FilippoGorini/DaisyTape/hardware/pcb/DaisyTape_BOTTOM.jpg

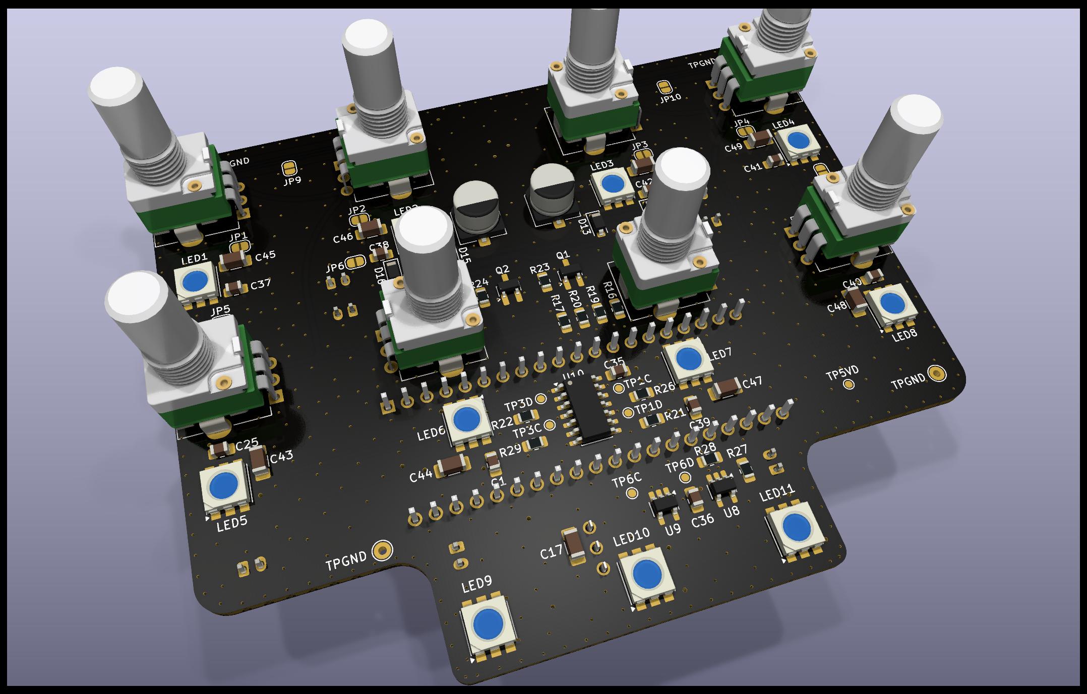
hardware/pcb/DaisyTape_BOTTOM.jpg
