FilippoGorini/DaisyTape/hardware/pcb/DaisyTape_TOP.png

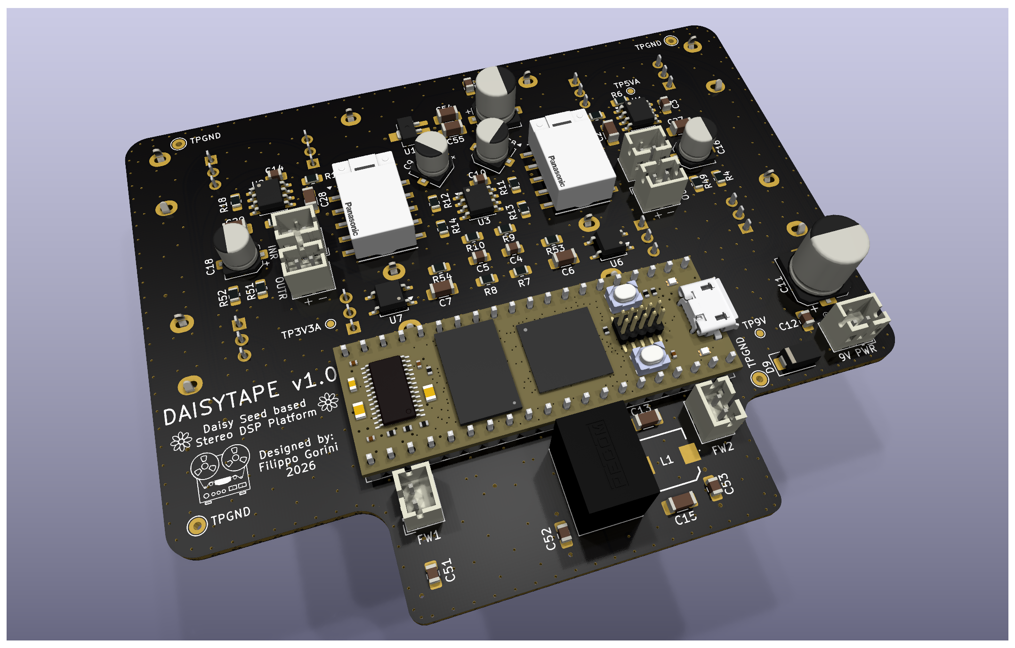
hardware/pcb/DaisyTape_TOP.png
