FilippoGorini/DaisyTape/README.md

# DaisyTape

## Author

<!-- Insert Your Name Here -->

## Description

<!-- Describe your example here -->
