FilippoGorini/DaisyTape/hardware/pcb/DaisyTape_BOTTOM.png

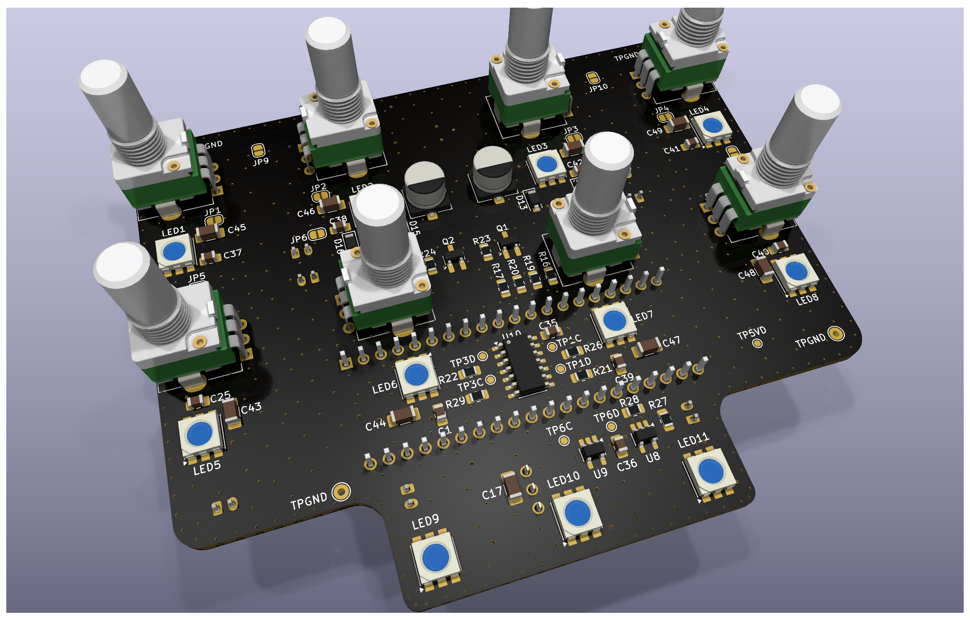
hardware/pcb/DaisyTape_BOTTOM.png
