FilippoGorini/DaisyTape/hardware/pcb/DaisyTape_TOP.jpg

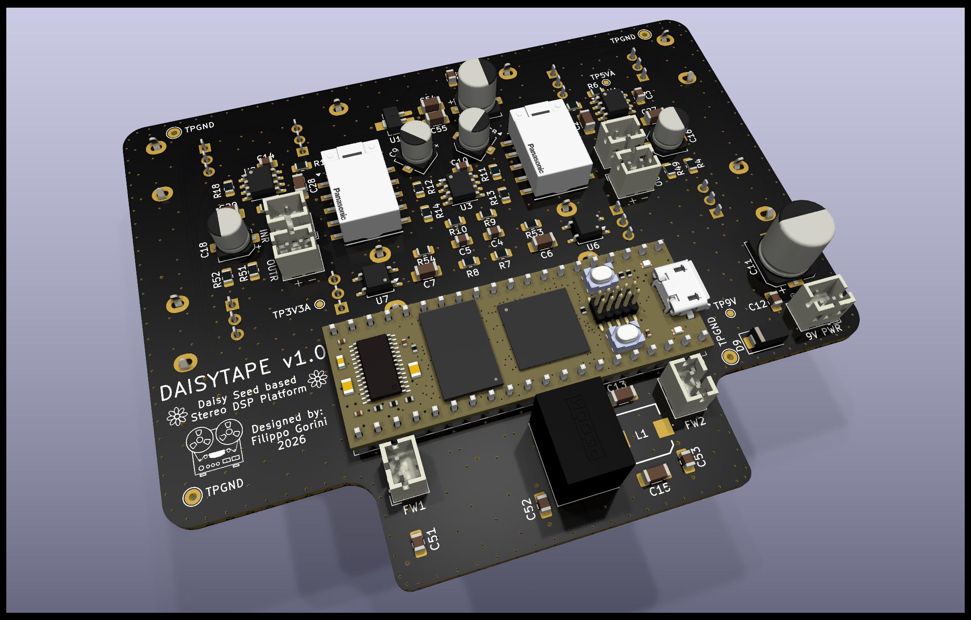
hardware/pcb/DaisyTape_TOP.jpg
