FilippoGorini/DaisyTape/hardware/pcb/DaisyTape_v2_4_layers.kicad_pcb

## KiCad design hardware/pcb/DaisyTape_v2_4_layers.kicad_pcb (2026-03-07)

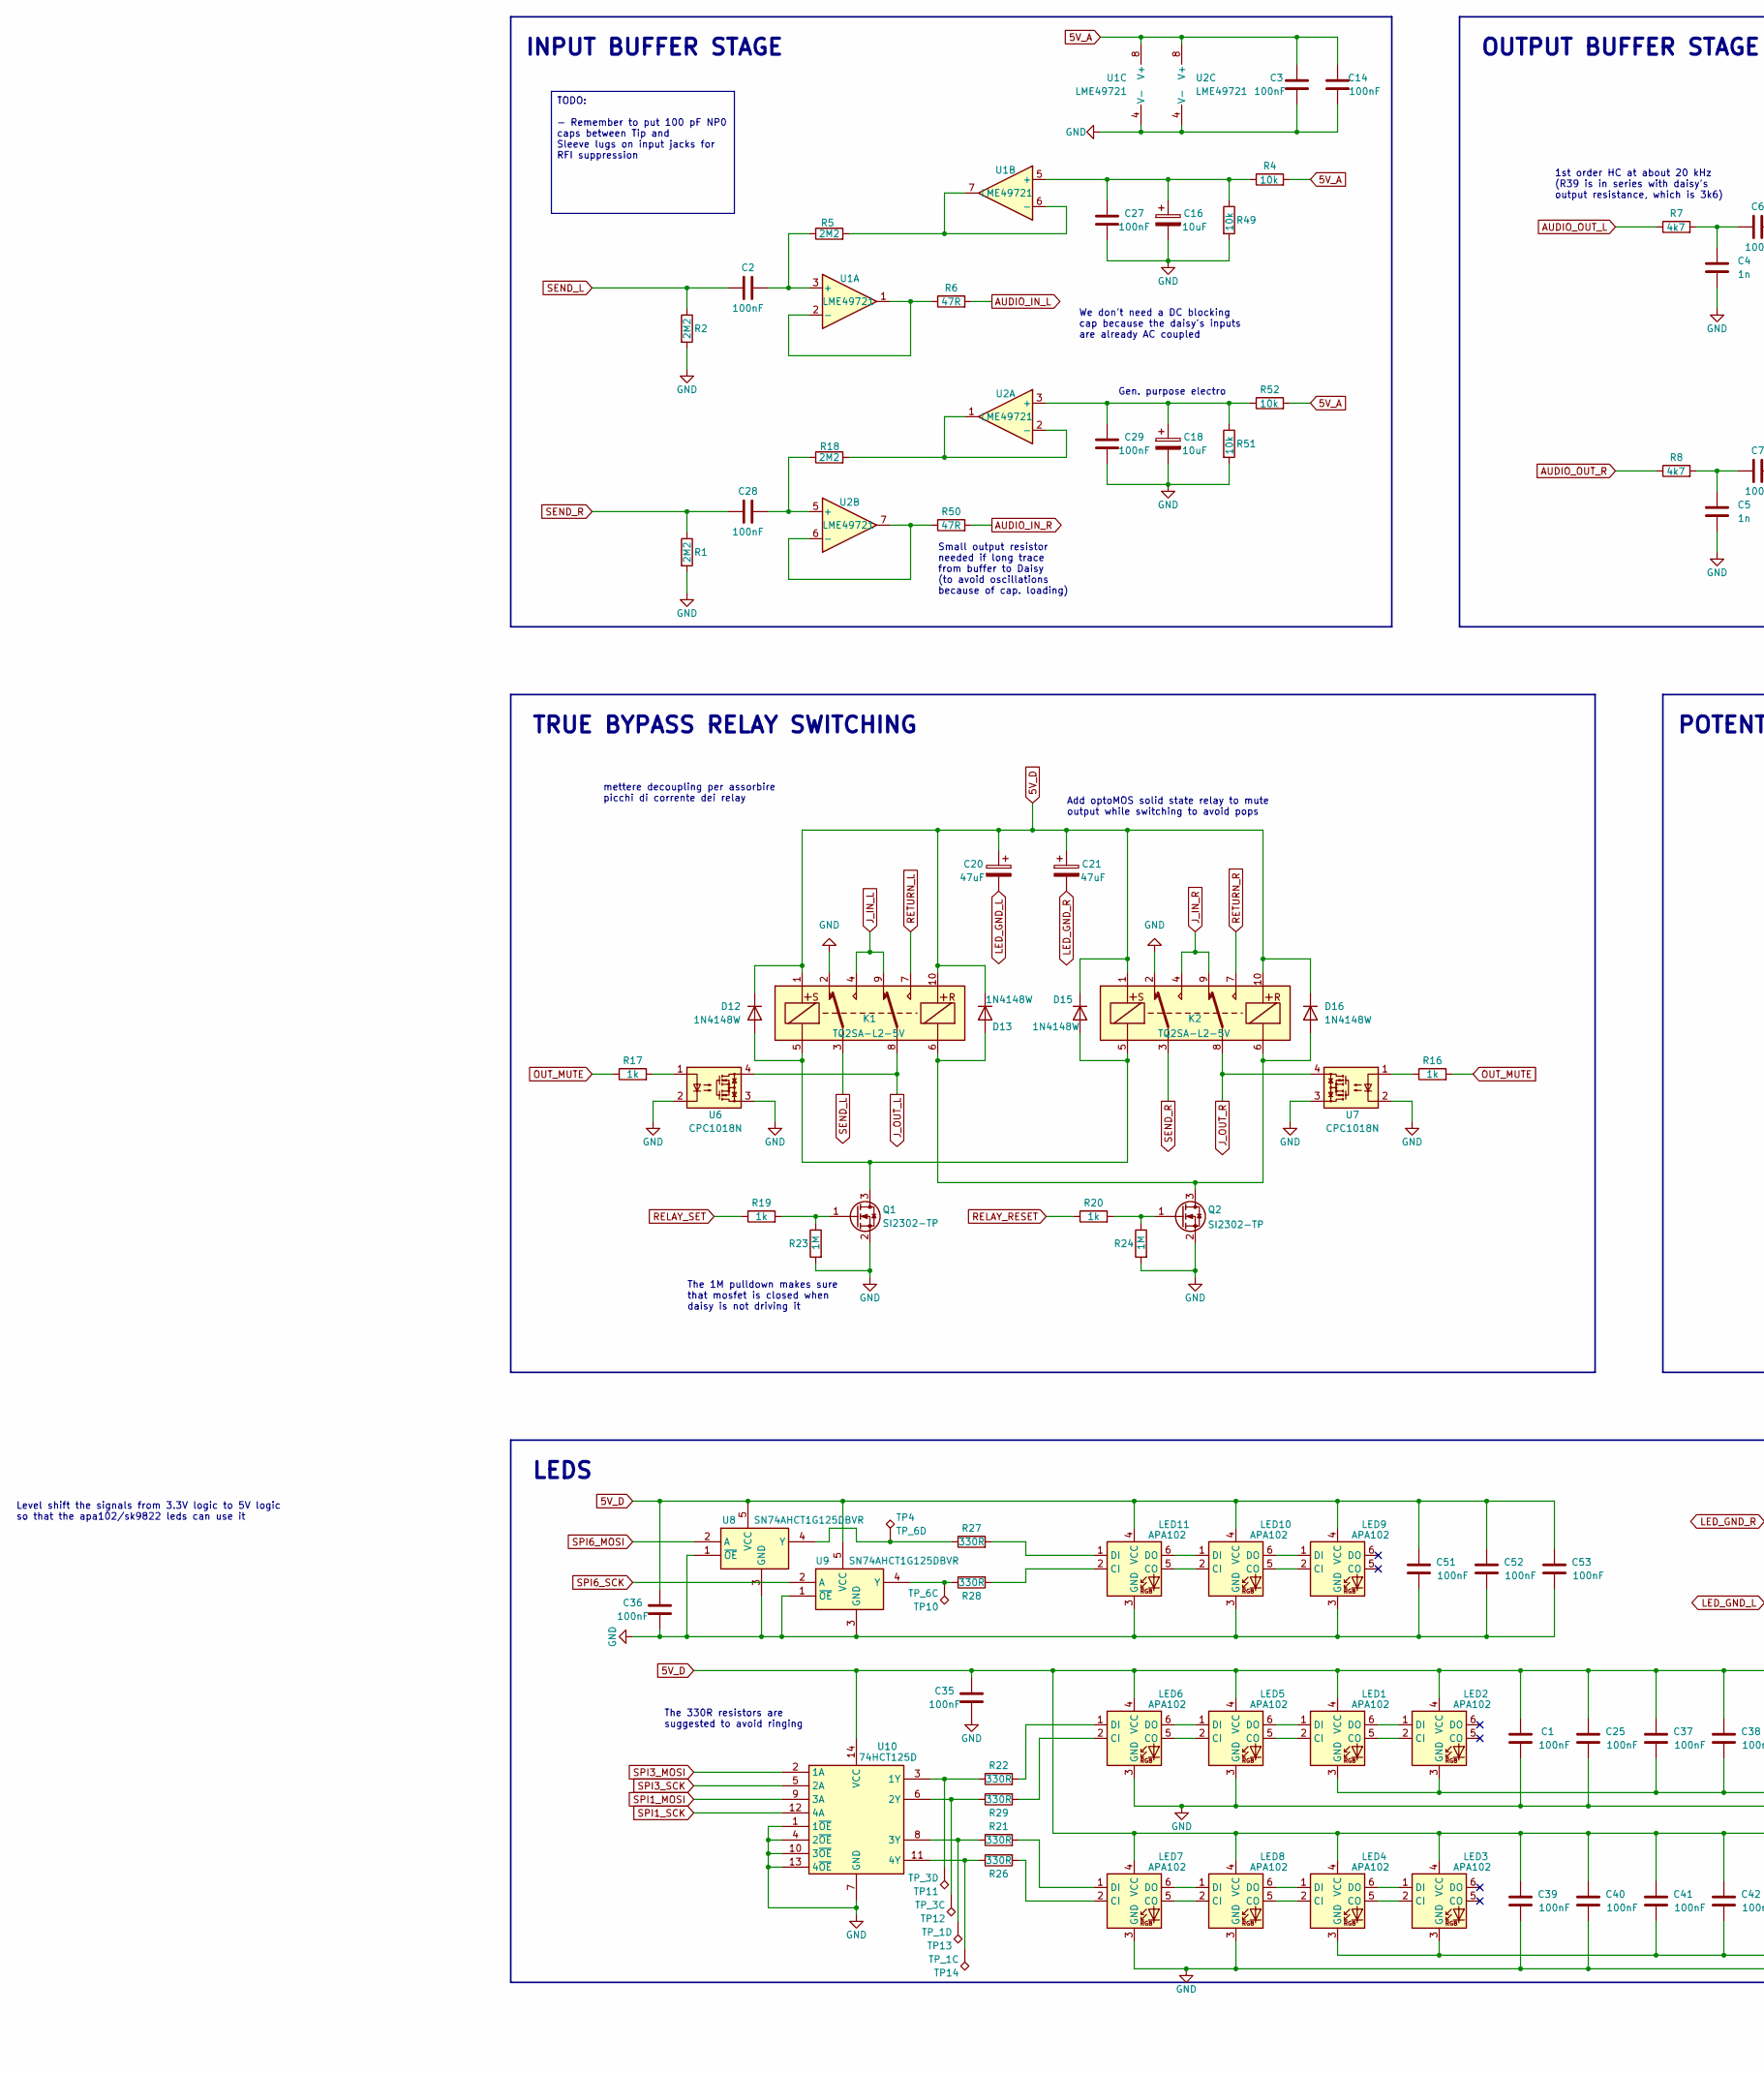
[picture p5: schematic DaisyTape_v2_4_layers.kicad_sch, part in row 1, column 1]

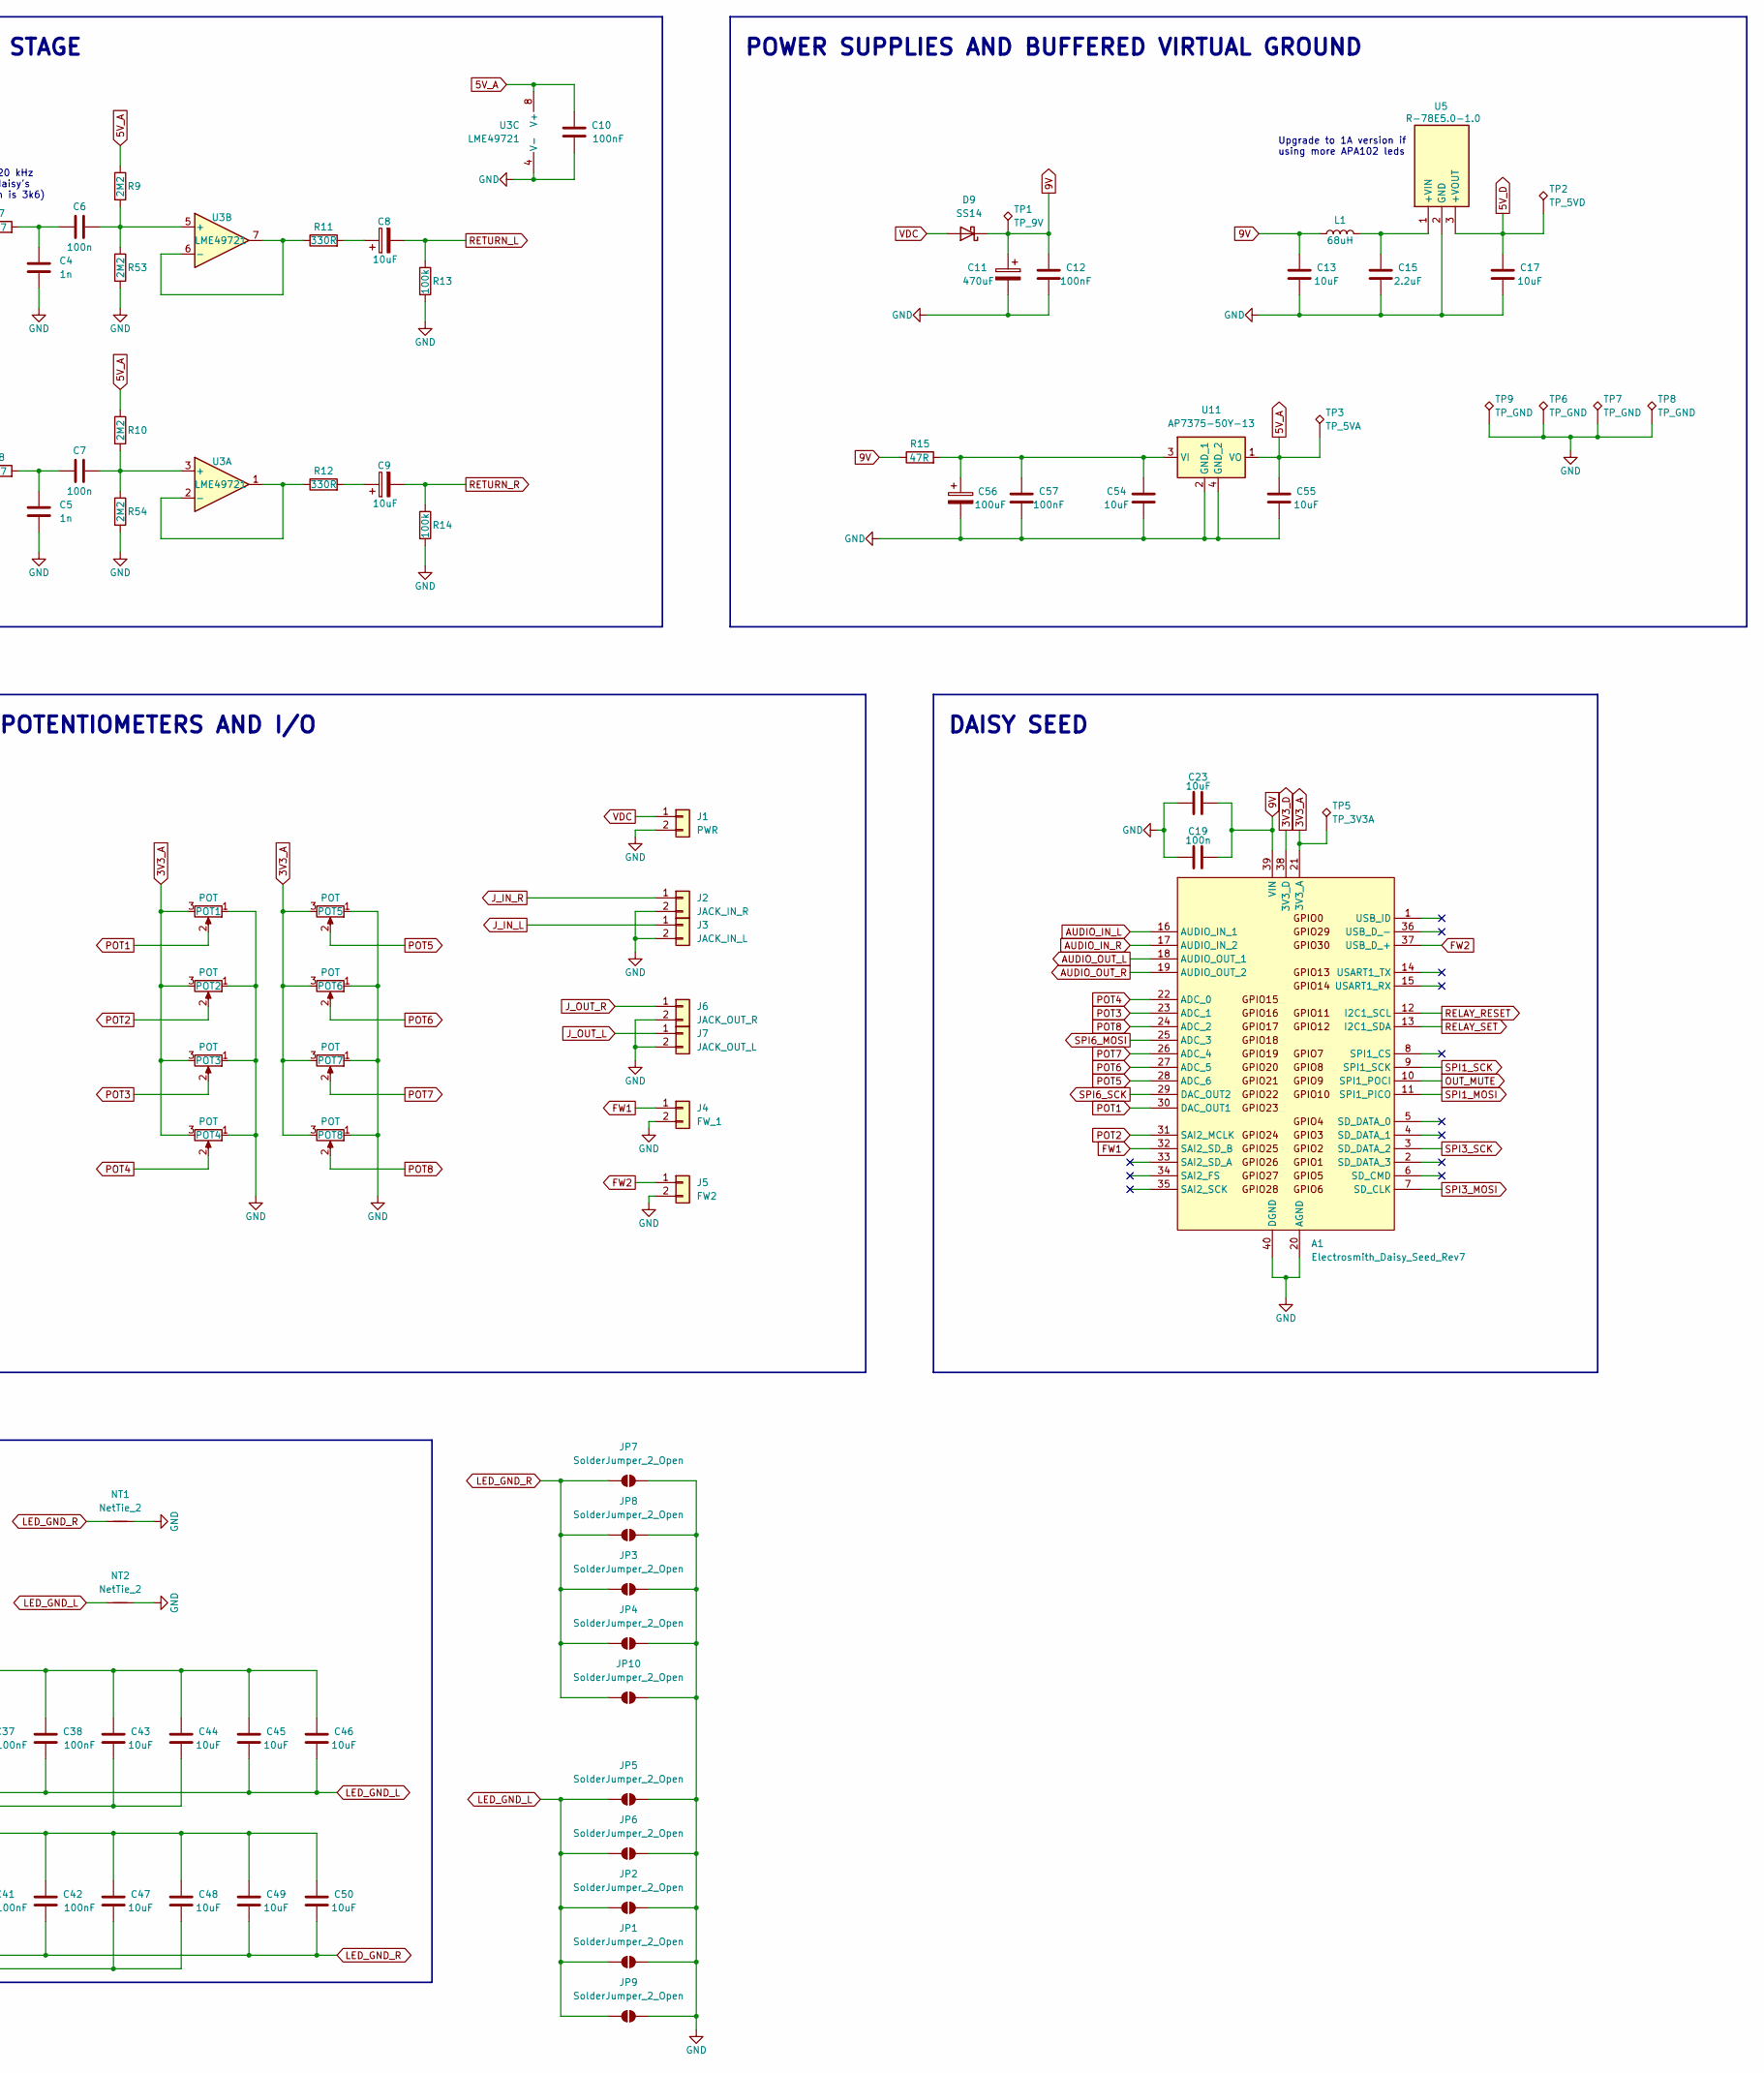
[picture p6: schematic DaisyTape_v2_4_layers.kicad_sch, part in row 1, column 2]

Parts:
A1: Electrosmith_Daisy_Seed_Rev7; Electrosmith_Daisy_Seed
C1, C3, C10, C12, C14, C25, C35, C36, C37, C38, C39, C40, C41, C42, C51, C52, C53, C57: 100nF; C_0805_2012Metric_Pad1.18x1.45mm_HandSolder
C2, C27, C28, C29: 100nF; C_1206_3216Metric_Pad1.33x1.80mm_HandSolder
C4, C5: 1n; C_0805_2012Metric_Pad1.18x1.45mm_HandSolder
C6, C7: 100n; C_1206_3216Metric_Pad1.33x1.80mm_HandSolder
C8, C9, C16, C18: 10uF; CP_Elec_5x5.8
C11: 470uF; CP_Elec_8x10
C13, C17, C23, C43, C44, C45, C46, C47, C48, C49, C50, C54, C55: 10uF; C_1206_3216Metric_Pad1.33x1.80mm_HandSolder
C15: 2.2uF; C_1206_3216Metric_Pad1.33x1.80mm_HandSolder
C19: 100n; C_0805_2012Metric_Pad1.18x1.45mm_HandSolder
C20, C21: 47uF; CP_Elec_6.3x5.4
C56: 100uF; CP_Elec_6.3x7.7
D9: SS14; D_SMA
D12, D13, D15, D16: 1N4148W; D_SOD-123
J1: PWR; JST_PH_B2B-PH-K_1x02_P2.00mm_Vertical
J2: JACK_IN_R; JST_PH_B2B-PH-K_1x02_P2.00mm_Vertical
J3: JACK_IN_L; JST_PH_B2B-PH-K_1x02_P2.00mm_Vertical
J4: FW_1; JST_PH_B2B-PH-K_1x02_P2.00mm_Vertical
J5: FW2; JST_PH_B2B-PH-K_1x02_P2.00mm_Vertical
J6: JACK_OUT_R; JST_PH_B2B-PH-K_1x02_P2.00mm_Vertical
J7: JACK_OUT_L; JST_PH_B2B-PH-K_1x02_P2.00mm_Vertical
JP1, JP2, JP3, JP4, JP5, JP6, JP7, JP8, JP9, JP10: SolderJumper_2_Open; SolderJumper-2_P1.3mm_Open_RoundedPad1.0x1.5mm
K1, K2: TQ2SA-L2-5V; TQ2SA; Mouser Part Number 769-TQ2SA-L2-5V
L1: 68uH; SRR7045680M
LED1, LED2, LED3, LED4, LED5, LED6, LED7, LED8, LED9, LED10, LED11: APA102; LED_RGB_5050-6
NT1, NT2: NetTie_2; NetTie-2_SMD_Pad1.0mm
POT1, POT2, POT3, POT4, POT5, POT6, POT7, POT8: POT; Potentiometer_Alpha_RD901F-40-00D_Single_Vertical
Q1, Q2: SI2302-TP; SOT-23_Handsoldering; Mouser Part Number 833-SI2302-TP
R1, R2, R5, R18: 2M2; R_0805_2012Metric_Pad1.20x1.40mm_HandSolder; Tolerance 1 %; MPN AC0805FR-072M2L
R4, R49, R51, R52: 10k; R_0805_2012Metric_Pad1.20x1.40mm_HandSolder
R6, R15, R50: 47R; R_0805_2012Metric_Pad1.20x1.40mm_HandSolder
R7, R8: 4k7; R_0805_2012Metric_Pad1.20x1.40mm_HandSolder
R9, R10, R53, R54: 2M2; R_0805_2012Metric_Pad1.20x1.40mm_HandSolder
R11, R12, R21, R22, R26, R27, R28, R29: 330R; R_0805_2012Metric_Pad1.20x1.40mm_HandSolder
R13, R14: 100k; R_0805_2012Metric_Pad1.20x1.40mm_HandSolder
R16, R17, R19, R20: 1k; R_0805_2012Metric_Pad1.20x1.40mm_HandSolder
R23, R24: 1M; R_0805_2012Metric_Pad1.20x1.40mm_HandSolder
TP1: TP_9V; TestPoint_Pad_D1.0mm
TP2: TP_5VD; TestPoint_Pad_D1.0mm
TP3: TP_5VA; TestPoint_Pad_D1.0mm
TP4: TP_6D; TestPoint_Pad_D1.0mm
TP5: TP_3V3A; TestPoint_Pad_D1.0mm
TP6, TP7, TP8, TP9: TP_GND; TestPoint_THTPad_D2.0mm_Drill1.0mm_CUSTOM
TP10: TP_6C; TestPoint_Pad_D1.0mm
TP11: TP_3D; TestPoint_Pad_D1.0mm
TP12: TP_3C; TestPoint_Pad_D1.0mm
TP13: TP_1D; TestPoint_Pad_D1.0mm
TP14: TP_1C; TestPoint_Pad_D1.0mm
U1, U2, U3: LME49721; SOIC-8_3.9x4.9mm_P1.27mm
U5: R-78E5.0-1.0; R78E5010; Mouser Part Number 919-R-78E5.0-1.0
U6, U7: CPC1018N; SOP-4_3.8x4.1mm_P2.54mm
U8, U9: SN74AHCT1G125DBVR; SOT-23-5_HandSoldering; Mouser Part Number 595-SNAHCT1G125DBVR
U10: 74HCT125D; SOIC-14_3.9x8.7mm_P1.27mm; Mouser Part Number 771-74HCT125D-T
U11: AP7375-50Y-13; SOT-89-3_Handsoldering; Mouser Part Number 621-AP7375-50Y-13

Connections:
3V3_A: A1.21 (3V3_A), POT1.3, POT2.3, POT3.3, POT4.3, POT5.3, POT6.3, POT7.3, POT8.3, TP5.1
3V3_D: A1.38 (3V3_D)
5V_A: C3.2, C10.2, C14.2, C55.2, R4.2, R9.1, R10.1, R52.2, TP3.1, U1.8 (V+), U2.8 (V+), U3.8 (V+), U11.1 (VO)
5V_D: C1.2, C17.2, C20.1, C21.1, C25.2, C35.2, C36.2, C37.2, C38.2, C39.2, C40.2, C41.2, C42.2, C43.2, C44.2, C45.2, C46.2, C47.2, C48.2, C49.2, C50.2, C51.2, C52.2, C53.2, D12.1 (K), D13.1 (K), D15.1 (K), D16.1 (K), K1.1, K1.10, K2.1, K2.10, LED1.4 (VCC), LED2.4 (VCC), LED3.4 (VCC), LED4.4 (VCC), LED5.4 (VCC), LED6.4 (VCC), LED7.4 (VCC), LED8.4 (VCC), LED9.4 (VCC), LED10.4 (VCC), LED11.4 (VCC), TP2.1, U5.3 (+VOUT), U8.5 (VCC), U9.5 (VCC), U10.14 (VCC)
9V: A1.39 (VIN), C11.1, C12.2, C13.2, C19.2, C23.2, D9.1 (K), L1.1, R15.1, TP1.1
AUDIO_IN_L: A1.16 (AUDIO_IN_1), R6.2
AUDIO_IN_R: A1.17 (AUDIO_IN_2), R50.2
AUDIO_OUT_L: A1.18 (AUDIO_OUT_1), R7.1
AUDIO_OUT_R: A1.19 (AUDIO_OUT_2), R8.1
FW1: A1.32 (SAI2_SD_B), J4.1
FW2: A1.37 (USB_D_+), J5.1
GND: A1.20 (AGND), A1.40 (DGND), C1.1, C3.1, C4.1, C5.1, C10.1, C11.2, C12.1, C13.1, C14.1, C15.1, C16.2, C17.1, C18.2, C19.1, C23.1, C25.1, C27.1, C29.1, C35.1, C36.1, C39.1, C40.1, C43.1, C44.1, C47.1, C48.1, C51.1, C52.1, C53.1, C54.1, C55.1, C56.2, C57.1, J1.2, J2.2, J3.2, J4.2, J5.2, J6.2, J7.2, JP1.2 (B), JP2.2 (B), JP3.2 (B), JP4.2 (B), JP5.2 (B), JP6.2 (B), JP7.2 (B), JP8.2 (B), JP9.2 (B), JP10.2 (B), K1.2, K2.2, LED5.3 (GND), LED6.3 (GND), LED7.3 (GND), LED8.3 (GND), LED9.3 (GND), LED10.3 (GND), LED11.3 (GND), NT1.2, NT2.2, POT1.1, POT2.1, POT3.1, POT4.1, POT5.1, POT6.1, POT7.1, POT8.1, Q1.2 (S), Q2.2 (S), R1.2, R2.2, R13.2, R14.2, R23.2, R24.2, R49.2, R51.2, R53.2, R54.2, TP6.1, TP7.1, TP8.1, TP9.1, U1.4 (V-), U2.4 (V-), U3.4 (V-), U5.2 (GND), U6.2, U6.3, U7.2, U7.3, U8.1 (~OE), U8.3 (GND), U9.1 (~OE), U9.3 (GND), U10.1 (1~OE), U10.4 (2~OE), U10.7 (GND), U10.10 (3~OE), U10.13 (4~OE), U11.2 (GND_1), U11.4 (GND_2)
J_IN_L: J3.1, K1.4, K1.9
J_IN_R: J2.1, K2.4, K2.9
J_OUT_L: J7.1, K1.8, U6.4
J_OUT_R: J6.1, K2.8, U7.4
LED_GND_L: C20.2, C37.1, C38.1, C45.1, C46.1, JP1.1 (A), JP2.1 (A), JP5.1 (A), JP6.1 (A), JP9.1 (A), LED1.3 (GND), LED2.3 (GND), NT2.1
LED_GND_R: C21.2, C41.1, C42.1, C49.1, C50.1, JP3.1 (A), JP4.1 (A), JP7.1 (A), JP8.1 (A), JP10.1 (A), LED3.3 (GND), LED4.3 (GND), NT1.1
unnamed: C4.2, C6.1, R7.2
unnamed: C5.2, C7.1, R8.2
unnamed: C8.1, R11.2
unnamed: C9.1, R12.2
unnamed: D12.2 (A), D15.2 (A), K1.5, K2.5, Q1.3 (D)
unnamed: D13.2 (A), D16.2 (A), K1.6, K2.6, Q2.3 (D)
unnamed: LED1.2 (CI), LED5.5 (CO)
unnamed: LED1.5 (CO), LED2.2 (CI)
unnamed: LED1.1 (DI), LED5.6 (DO)
unnamed: LED1.6 (DO), LED2.1 (DI)
unnamed: LED3.2 (CI), LED4.5 (CO)
unnamed: LED3.1 (DI), LED4.6 (DO)
unnamed: LED4.2 (CI), LED8.5 (CO)
unnamed: LED4.1 (DI), LED8.6 (DO)
unnamed: LED5.2 (CI), LED6.5 (CO)
unnamed: LED5.1 (DI), LED6.6 (DO)
unnamed: LED6.2 (CI), R29.2
unnamed: LED6.1 (DI), R22.2
unnamed: LED7.2 (CI), R26.2
unnamed: LED7.5 (CO), LED8.2 (CI)
unnamed: LED7.1 (DI), R21.2
unnamed: LED7.6 (DO), LED8.1 (DI)
unnamed: LED10.2 (CI), LED11.5 (CO)
unnamed: LED9.2 (CI), LED10.5 (CO)
unnamed: LED10.1 (DI), LED11.6 (DO)
unnamed: LED9.1 (DI), LED10.6 (DO)
unnamed: LED11.2 (CI), R28.2
unnamed: LED11.1 (DI), R27.2
unnamed: Q1.1 (G), R19.2, R23.1
unnamed: Q2.1 (G), R20.2, R24.1
unnamed: R16.1, U7.1
unnamed: R17.2, U6.1
unnamed: C2.2, R5.1, U1.3 (+)
unnamed: R6.1, U1.1, U1.2 (-)
unnamed: C16.1, C27.2, R4.1, R49.1, U1.5 (+)
unnamed: R5.2, U1.6 (-), U1.7
unnamed: C18.1, C29.2, R51.1, R52.1, U2.3 (+)
unnamed: R18.2, U2.1, U2.2 (-)
unnamed: C28.2, R18.1, U2.5 (+)
unnamed: R50.1, U2.6 (-), U2.7
unnamed: C7.2, R10.2, R54.1, U3.3 (+)
unnamed: R12.1, U3.1, U3.2 (-)
unnamed: C6.2, R9.2, R53.1, U3.5 (+)
unnamed: R11.1, U3.6 (-), U3.7
unnamed: C15.2, L1.2, U5.1 (+VIN)
unnamed: R27.1, TP4.1, U8.4 (Y)
unnamed: R28.1, TP10.1, U9.4 (Y)
unnamed: R22.1, TP11.1, U10.3 (1Y)
unnamed: R29.1, TP12.1, U10.6 (2Y)
unnamed: R21.1, TP13.1, U10.8 (3Y)
unnamed: R26.1, TP14.1, U10.11 (4Y)
unnamed: C54.2, C56.1, C57.2, R15.2, U11.3 (VI)
OUT_MUTE: A1.10 (SPI1_POCI), R16.2, R17.1
POT1: A1.30 (DAC_OUT1), POT1.2
POT2: A1.31 (SAI2_MCLK), POT2.2
POT3: A1.23 (ADC_1), POT3.2
POT4: A1.22 (ADC_0), POT4.2
POT5: A1.28 (ADC_6), POT5.2
POT6: A1.27 (ADC_5), POT6.2
POT7: A1.26 (ADC_4), POT7.2
POT8: A1.24 (ADC_2), POT8.2
RELAY_RESET: A1.12 (I2C1_SCL), R20.1
RELAY_SET: A1.13 (I2C1_SDA), R19.1
RETURN_L: C8.2, K1.7, R13.1
RETURN_R: C9.2, K2.7, R14.1
SEND_L: C2.1, K1.3, R2.1
SEND_R: C28.1, K2.3, R1.1
SPI1_MOSI: A1.11 (SPI1_PICO), U10.9 (3A)
SPI1_SCK: A1.9 (SPI1_SCK), U10.12 (4A)
SPI3_MOSI: A1.7 (SD_CLK), U10.2 (1A)
SPI3_SCK: A1.3 (SD_DATA_2), U10.5 (2A)
SPI6_MOSI: A1.25 (ADC_3), U8.2 (A)
SPI6_SCK: A1.29 (DAC_OUT2), U9.2 (A)
VDC: D9.2 (A), J1.1

Notes on the sheet:
POWER SUPPLIES AND BUFFERED VIRTUAL GROUND
The 330R resistors are suggested to avoid ringing
The 1M pulldown makes sure that mosfet is closed when daisy is not driving it
LEDS
Level shift the signals from 3.3V logic to 5V logic so that the apa102/sk9822 leds can use it
INPUT BUFFER STAGE
mettere decoupling per assorbire picchi di corrente dei relay
DAISY SEED
POTENTIOMETERS AND I/O
TRUE BYPASS RELAY SWITCHING
We don't need a DC blocking cap because the daisy's inputs are already AC coupled
Small output resistor needed if long trace from buffer to Daisy (to avoid oscillations because of cap. loading)
Upgrade to 1A version if using more APA102 leds
OUTPUT BUFFER STAGE
Add optoMOS solid state relay to mute output while switching to avoid pops
Gen. purpose electro
1st order HC at about 20 kHz (R39 is in series with daisy's output resistance, which is 3k6)
TODO: - Remember to put 100 pF NP0 caps between Tip and Sleeve lugs on input jacks for RFI suppression

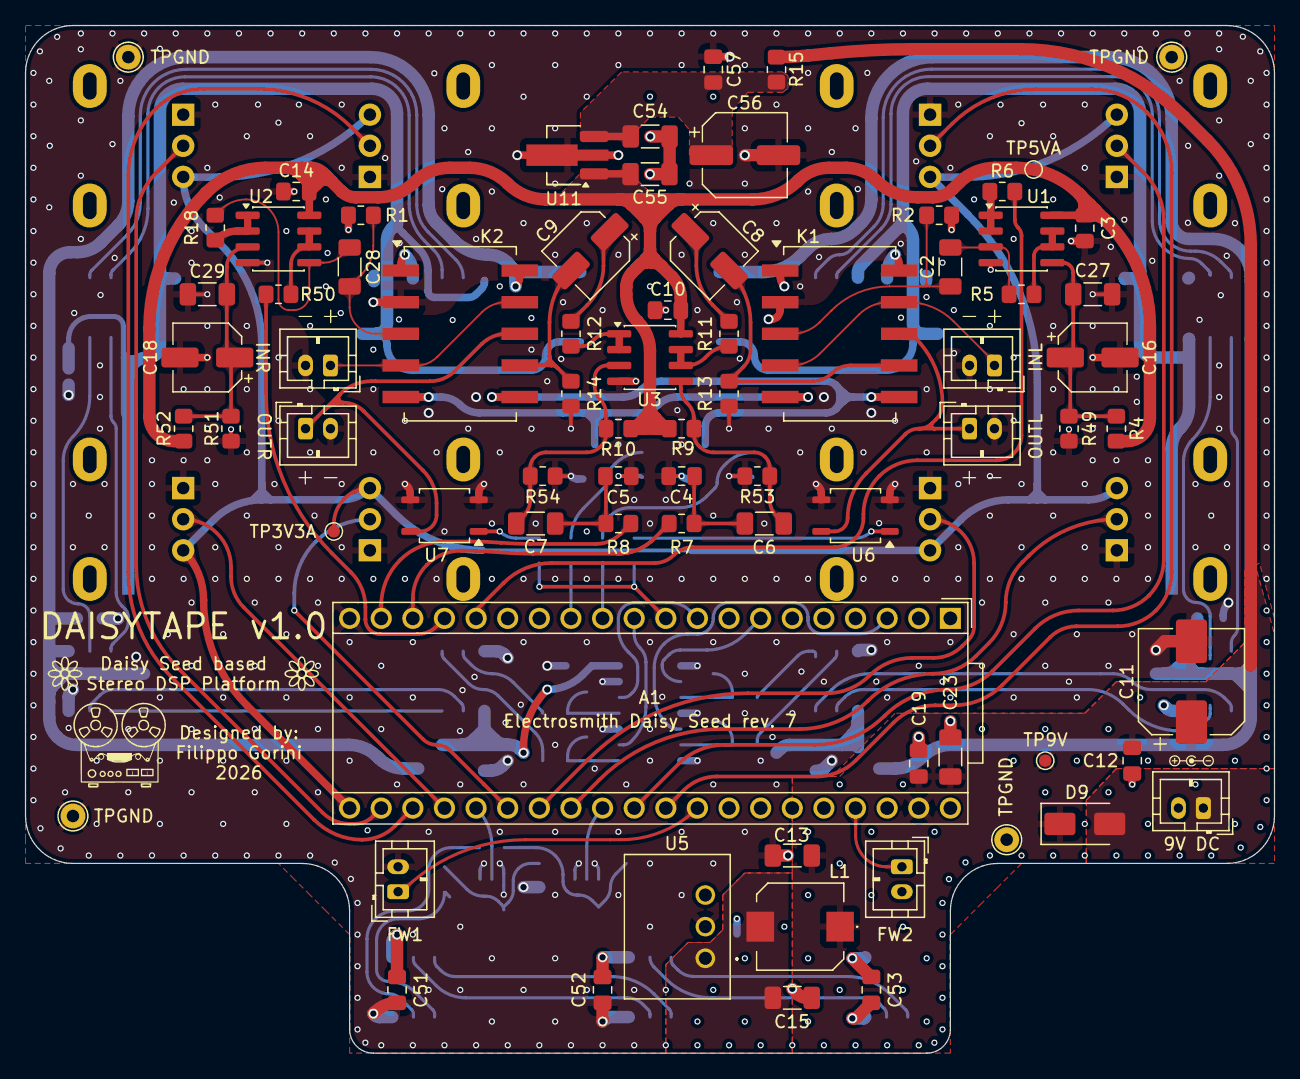
[picture p7: board DaisyTape_v2_4_layers.kicad_pcb from above]

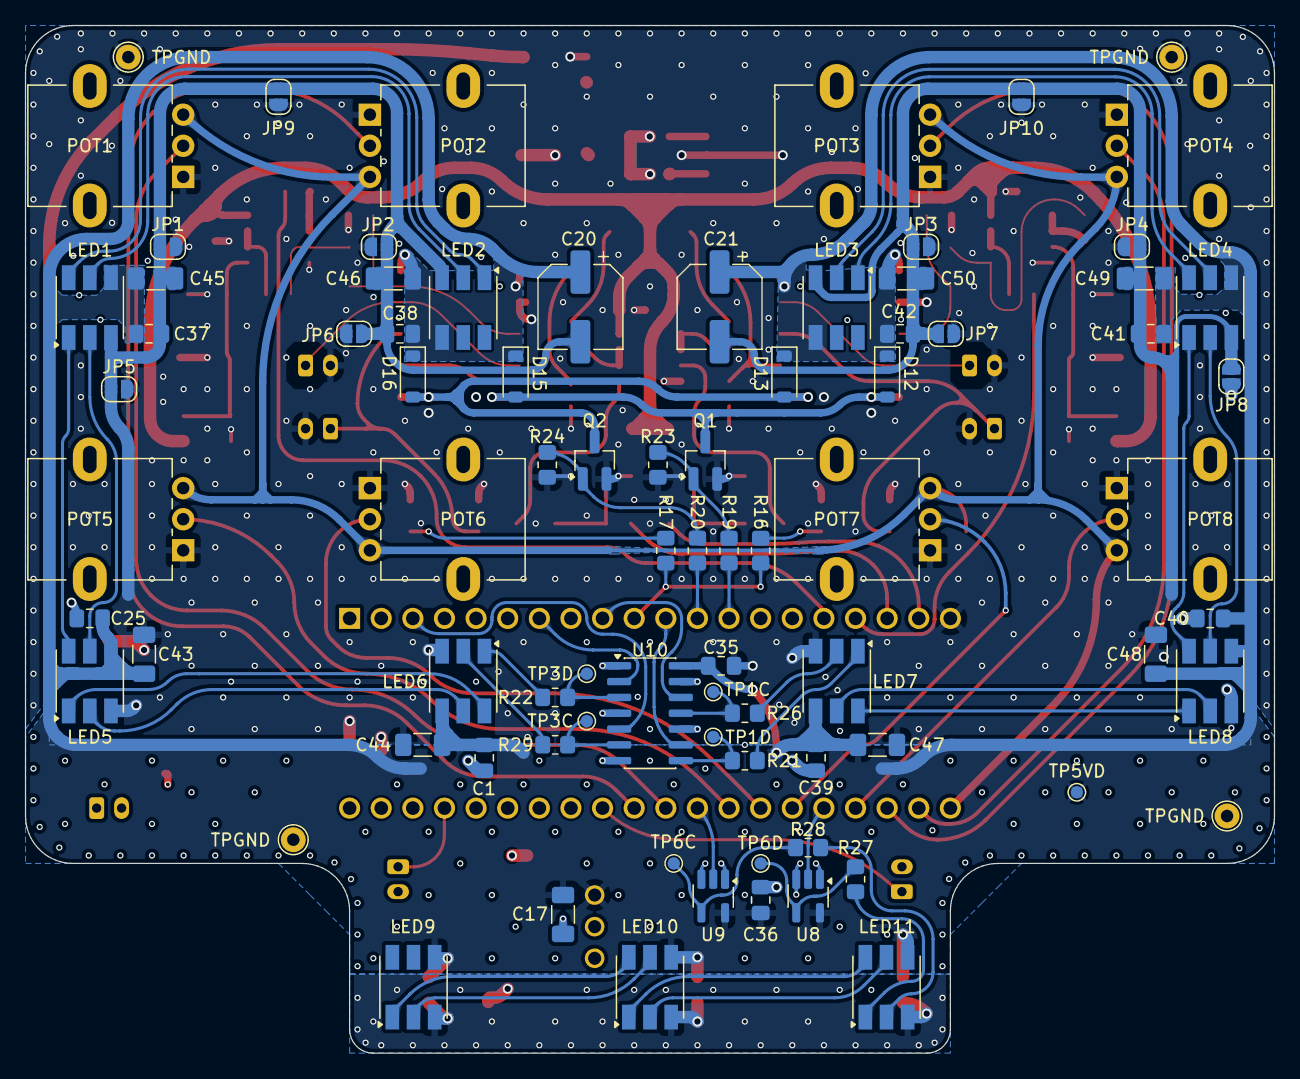
[picture p8: board DaisyTape_v2_4_layers.kicad_pcb from below]

Board: 4 copper layers, 100.3 x 82.5 mm, 155 parts (80 on the bottom side), 91 nets.
