FilippoGorini/DaisyTape/(commit log)

2025-11-18 InputFilters class ported and working
    - Succesfully ported Linkwitz-Riley, DaisyInputFilters, and TapeProcessor classes
    - New project structure with separate include and src directories
    - Input filters now working correctly
    ISSUES:
    - When moving the pots too fast there are audible artifacts, maybe we need smoothing or a different rate?
    - We can't yet test the wet dry mix and the makeup until we know how much the needed delay is
    TODO:
    - Check the size of SDRAM buffers
    - Move (maybe???) the parameter structure in the TapeProcessor class and add a updateParams() method instead of using a function in the main file
    - In general check where to declare variables etc
    - Setup an enum for the adc ch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
    [Config.h, DaisyInputFilters.cpp, DaisyInputFilters.h, DaisyLinkwitzRiley.h, DaisyTape.cpp, TapeProcessor.cpp, TapeProcessor.h]
2025-11-19 Slight refactor, new updateParams() method, new TapeParams structure
    - Moved params structure inside of TapeProcessor and added updateParams() method
    - Slight refactor of main loop to read pots, update params, log status separately
    - When moving the pots too fast there are audible artifacts, maybe we need smoothing or a different rate? UPDATE: higher rate helps slightly but the problem remains
    - Setup an enum for the adc channels names as suggested on the daisy audio reference
    - Try the smoothing of t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
    [DaisyTape.cpp, TapeProcessor.cpp, TapeProcessor.h]
2025-11-24 Added loss filter processing, azimuth yet to fix
    - Added DaisyLossFilter and DaisyAzimuthProc classes (Azimuth has problems so it is not used yet)
    - Added the loss filter processing in the TapeProcessor class
    - Implemented the logging at a slower rate wrt parameter updates
    - The azimuth processing is behaving strangely (additional delayed sound at a lower volume)
    - In general check where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
    [DaisyAzimuthProc.cpp, DaisyAzimuthProc.h, DaisyLossFilter.cpp, DaisyLossFilter.h, DaisyTape.cpp, TapeProcessor.cpp, TapeProcessor.h]
2025-11-24 Improvements to the DaisyLossFilter class (RBJ head-bump filter, increased FIR order)
    - Improved DaisyLossFilter by using RBJ implementation as the original JUCE code did instead of the naive biquad formula
    - Increased loss filter FIR filter order to 70 to better match the spectral bins size of the original implementation running at 44.1 kHz
    - Added matlab script to compare the coefficients of the two implementations
    - Sometimes the audio cuts out and totally glitches out, not sure if hardware problem or a loss filter software issue
    - When moving the pots too fast there are audible artifacts,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
    [DaisyLossFilter.cpp, DaisyLossFilter.h]
2025-11-24 Added DaisyDegrade processor
    - Added DaisyDegrade class, which seems to behave as expected but is not really convincing, gotta compare more in depth with original code
    - There seems to be some non predicatability given by the Degrade class which causes rare audio callback underruns
    - We're getting close to the flash memory limit
    - When moving the pots too fast there are audible artifacts, maybe we need smoothing or a different rate? UPDATE: higher rate helps slightly but the p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
    [DaisyDegrade.cpp, DaisyDegrade.h, DaisyTape.cpp, TapeProcessor.cpp, TapeProcessor.h]
2025-11-25 DaisyDegrade class improvements to increase accuracy wrt original implementation and reduce CPU load
    - Modified the DaisyDegrade class to use similar logic to JUCE's Random and SmoothedValue classes
    - This also seems to give more predictability, as now the average CPU load is 24% and the max is 44%, compared to the previous peaks of 96%
    - Ported JuceRandom, LinSmoothed, MulSmoothed and ChowLevelDetector from JUCE and chowdsp libraries
    - The azimuth processing is behaving strangely (additional delayed sound at a lower vo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
    [DaisyDegrade.cpp, DaisyDegrade.h, DaisyTape.cpp, TapeProcessor.cpp, TapeProcessor.h]
2025-11-25 Just fixed vscode warning by adding an std:: somewhere, not really needed though
    [DaisyDegrade.h]
2025-12-02 Updated main to use all 8 knobs instead of 4, discovered possible cause of glitches
    - CRITICAL: the updateParams can be interrupted by the audio callback, this causes incoherent parameter sets which could trigger IIR instabilities, this could be the cause of the destructive audio glitch mentioned down here
    - Sometimes the audio cuts out and totally glitches out, not sure if hardware problem or a loss filter software issue (probable IIR instability at this point)
    - When moving the pots too fast there are audible artifacts, maybe we need smoothing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
    [DaisyTape.cpp]
2026-03-07 Moved program to SRAM, added PCB project
    [DaisyTape_v2_4_layers.csv, DaisyTape_v2_4_layers.kicad_pcb, DaisyTape_v2_4_layers.kicad_sch, bom.csv, designators.csv, positions.csv]
2026-05-05 Refactored all critical classes to prepareParams() in main thread and applyParams() in the audio callback, maybe problem fixed?
    DONE:
    - Refactored all critical classes: now the parameters are prepared in main thread but applied inside of a single audio callback only once they're ready
    - When moving the pots too fast there are audible artifacts, maybe we need smoothing or a different rate? UPDATE: higher rate helps slightly but the problem remains. Regarding this, maybe let's check if the problem is still there now that we are running at a smalle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
    [DaisyDegrade.cpp, DaisyDegrade.h, DaisyInputFilters.cpp, DaisyInputFilters.h, DaisyLossFilter.cpp, DaisyLossFilter.h, TapeProcessor.cpp, TapeProcessor.h]
